schnommus/smart_cutlery_pcb/README.md

# Smart Cutlery (PCB)
ELEC3117 project, 2017S2. Jamon & Seb.
