schnommus/smart_cutlery_pcb/fab_out/rev1_pattern1/bom_digikey.xls

Refs | Value | Footprint | QTY (1 unit) | MFR | MPN | SPR | SPN | QTY (to order) | UNITS
BT1 | 3V CR1225 | BC_2011_CR1225_HOLDER:BC-2011-CR1225 | 1 | MPD (Memory Protection Devices) | BC-2011 | https://www.digikey.com.au/ | BC-2011-ND | 3 | 3
SW1 | TL3342 | Buttons_Switches_SMD:SW_SPST_TL3342 | 1 | E-Switch | TL3342F160QG/TR | https://www.digikey.com.au/ | EG2531CT-ND | 3
C8 | 100uF | Capacitors_Tantalum_SMD:CP_Tantalum_Case-B_EIA-3528-21_Reflow | 1 | AVX | F930J107MBA | https://www.digikey.com.au/ | 478-8156-1-ND | 3
C10 | 10uF | Capacitors_Tantalum_SMD:CP_Tantalum_Case-B_EIA-3528-21_Reflow | 1 | Vishay Sprague | 293D106X9016B2TE3 | https://www.digikey.com.au/ | 718-1124-1-ND | 3
C11 | 68uF | Capacitors_Tantalum_SMD:CP_Tantalum_Case-B_EIA-3528-21_Reflow | 1 | AVX | F930J686MBA | https://www.digikey.com.au/ | 478-8190-1-ND | 3
D3;D4;D5 | MBR0520 | Diodes_SMD:D_SOD-123 | 3 | Fairchild/ON | MBR0520L | https://www.digikey.com.au/ | MBR0520LCT-ND | 9
U4 | MPU-9250 | Housings_DFN_QFN:QFN-24-1EP_3x3mm_Pitch0.4mm | 1 | TDK InvenSense | MPU-9250 | https://www.digikey.com.au/ | 1428-1019-1-ND | 3
U1 | STM32L053C6Tx | Housings_QFP:LQFP-48_7x7mm_Pitch0.5mm | 1 | STMicroelectronics | STM32L053C8T6 | https://www.digikey.com.au/ | 497-14906-ND | 3
L2;L1 | 47uH | Inductors_SMD:L_0603 | 2 | Taiyo Yuden | CBMF1608T470K | https://www.digikey.com.au/ | 587-1722-1-ND | 6
U5 | ASMT-YTC2-0AA02 | LEDs:LED_RGB_PLCC-6 | 1 | Broadcom | ASMT-YTC2-0AA02 | https://www.digikey.com.au/ | 516-2513-1-ND | 3
Q2 | BSS138 | TO_SOT_Packages_SMD:SOT-23 | 1 | Fairchild/ON | BSS138L | https://www.digikey.com.au/ | BSS138LCT-ND | 3
Q1 | BSS84 | TO_SOT_Packages_SMD:SOT-23 | 1 | Diodes Inc. | BSS84-7-F | https://www.digikey.com.au/ | BSS84-FDICT-ND | 3
