schnommus/smart_cutlery_pcb/smart_cutlery_pcb.kicad_pcb

## KiCad design smart_cutlery_pcb.kicad_pcb (2017-09-09)

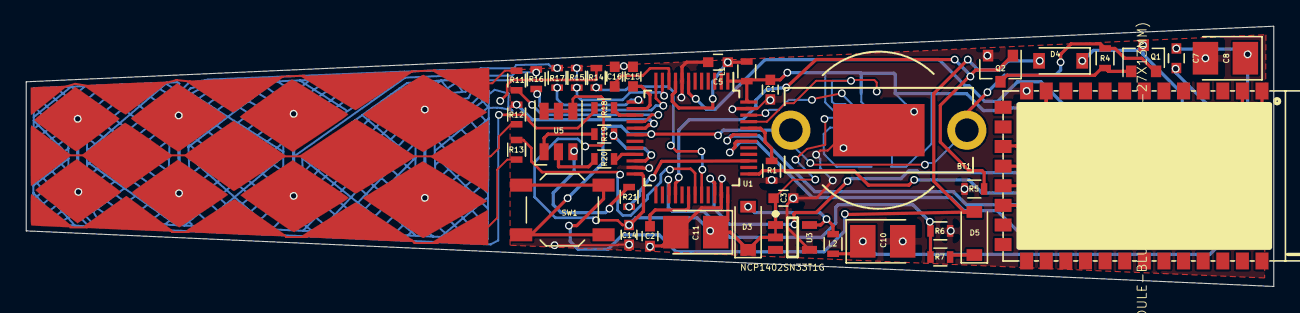
[picture p1: board smart_cutlery_pcb.kicad_pcb from above]

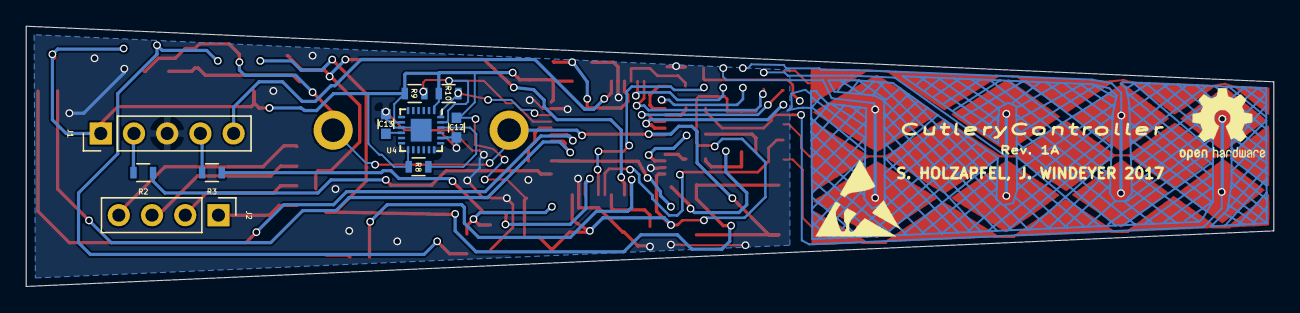
[picture p2: board smart_cutlery_pcb.kicad_pcb from below]

Board: 2 copper layers, 95.4 x 19.9 mm, 50 parts (10 on the bottom side), 44 nets.

Parts:
BT1: 3V CR1225; BC-2011-CR1225
C1, C2, C3, C5: 100n; C_0603
C7, C12, C13: 100nF; C_0603
C8: 100uF; CP_Tantalum_Case-B_EIA-3528-21_Reflow
C10: 10uF; CP_Tantalum_Case-B_EIA-3528-21_Reflow
C11: 68uF; CP_Tantalum_Case-B_EIA-3528-21_Reflow
C14, C15, C16: 47nF; C_0603
D3, D4, D5: MBR0520; D_SOD-123
J1: CONN_01X05; Pin_Header_Straight_1x05_Pitch2.54mm
J2: CONN_01X04; Pin_Header_Straight_1x04_Pitch2.54mm
L1: Ferrite; L_0603
L2: 47uH; L_0603
Q1: BSS84; SOT-23
Q2: BSS138; SOT-23
R1: 4.7k; R_0603
R2, R3: 100; R_0603
R4, R5: 100K; R_0603
R6: 4K7; R_0603
R7: 47K; R_0603
R8, R9, R10, R11, R12, R13, R14, R15, R16, R17, R18: 10K; R_0603
R19, R20, R21: 180; R_0603
SW1: TL3342; SW_SPST_TL3342
U1: STM32L053C6Tx; LQFP-48_7x7mm_Pitch0.5mm
U2: MODULE-BLUETOOTH-HC-05(34P-27X13MM); BT34P-SMD-1.5-26.9X13.0X2.2MM
U3: NCP1402SN33T1G; SOT95P275X110-5N
U4: MPU-9250; QFN-24-1EP_3x3mm_Pitch0.4mm
U5: ASMT-YTC2-0AA02; LED_RGB_PLCC-6

Connections:
+3V3: C1.1, C2.1, C3.1, C7.1, C8.1, C11.1, C12.1, D3.1, J1.1, L1.1, R8.1, R9.1, R10.1, U1.1, U1.24, U1.36, U1.48, U2.12, U3.1, U3.2, U4.1, U4.8, U4.13, U5.4, U5.5, U5.6
/ACCEL_GYRO_I2C_SCL: R9.2, U1.45, U4.23
/ACCEL_GYRO_I2C_SDA: R10.2, U1.46, U4.24
/BAT1_VSENSE: BT1.1, Q1.2, R4.2, SW1.1, U1.18
/BLUETOOTH_RX: U1.42, U2.2
/BLUETOOTH_TX: U1.43, U2.1
/LED_BLUE: R19.2, U1.22
/LED_GREEN: R20.2, U1.21
/LED_RED: R21.2, U1.39
/PWR_BUTTON: R6.1, R7.2, U1.27
/PWR_LATCH: Q2.1, R5.2, U1.28
/micro/SWD_CLK: R2.1, U1.37
/micro/SWD_IO: R3.1, U1.34
/micro/nRST: J1.5, U1.7
/touch_cap1: C16.2, U1.10
/touch_cap2: C15.2, U1.14
/touch_cap3: C14.2, U1.30
/touch_x1: R15.2, U1.11
/touch_x2: R16.2, U1.12
/touch_x3: R17.2, U1.13
/touch_x4: R18.2, U1.15
/touch_y1: R11.2, U1.16
/touch_y2: R12.2, U1.17
/touch_y3: R13.2, U1.31
/touch_y4: R14.2, U1.32
GND: BT1.2, C1.2, C2.2, C3.2, C5.2, C7.2, C8.2, C10.2, C11.2, C12.2, C13.2, C14.1, C15.1, C16.1, J1.3, Q2.2, R1.2, R5.1, R7.1, U1.8, U1.23, U1.35, U1.47, U2.13, U3.4, U4.9, U4.18, U4.20
unnamed: C5.1, L1.2, U1.9
unnamed: C10.1, D4.1, L2.1, Q1.3
unnamed: C13.1, U4.10
unnamed: D3.2, L2.2, U3.5
unnamed: D4.2, D5.2, SW1.2
unnamed: D5.1, R6.2
unnamed: J1.2, R2.2
unnamed: J1.4, R3.2
unnamed: J2.1, U2.19
unnamed: J2.2, U2.18
unnamed: J2.3, U2.17
unnamed: J2.4, U2.16
unnamed: Q1.1, Q2.3, R4.1
unnamed: R1.1, U1.44
unnamed: R8.2, U4.22
unnamed: R19.1, U5.1
unnamed: R20.1, U5.2
unnamed: R21.1, U5.3
