schnommus/smart_cutlery_pcb/boost_conv_tests.ods

L=47uH
V_in | I_in | P_in | V_out | R_out | P_out | EFF | I_out | V | Eff (47uH) | Eff (94uH)
2 | 0.102 | 0.204 | 3.3 | 800 | 0.0136125 | 0.066727941176471 | 0.004125 | 2V | 0.068671699323855 | 0.242710193492143
2 | 0.079 | 0.158 | 3.3 | 1000 | 0.01089 | 0.068924050632911 | 0.0033 | 2.5V | 0.073935971415214 | 0.189867040472222
2 | 0.059 | 0.118 | 3.3 | 1500 | 0.00726 | 0.061525423728814 | 0.0022 | 3V | 0.386949867073248 | 0.17797764924411
2 | 0.0375 | 0.075 | 3.3 | 2000 | 0.005445 | 0.0726 | 0.00165
2 | 0.0185 | 0.037 | 3.3 | 4000 | 0.0027225 | 0.073581081081081 | 0.000825
2.5 | 0.093 | 0.2325 | 3.3 | 800 | 0.0136125 | 0.058548387096774 | 0.004125
2.5 | 0.07 | 0.175 | 3.3 | 1000 | 0.01089 | 0.062228571428572 | 0.0033
2.5 | 0.045 | 0.1125 | 3.3 | 1500 | 0.00726 | 0.064533333333333 | 0.0022
2.5 | 0.033 | 0.0825 | 3.3 | 2000 | 0.005445 | 0.066 | 0.00165
2.5 | 0.0092 | 0.023 | 3.3 | 4000 | 0.0027225 | 0.118369565217391 | 0.000825
3 | 0.0114 | 0.0342 | 3.3 | 800 | 0.0136125 | 0.398026315789474 | 0.004125
3 | 0.009 | 0.027 | 3.3 | 1000 | 0.01089 | 0.403333333333333 | 0.0033
3 | 0.006 | 0.018 | 3.3 | 1500 | 0.00726 | 0.403333333333333 | 0.0022
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
