schnommus/smart_cutlery_pcb/(commit log)

2017-08-24 Added STM32L053 sub-schematic with debugging header etc
    [micro.sch, smart_cutlery_pcb.kicad_pcb, smart_cutlery_pcb.sch]
2017-08-24 Add bluetooth HC-05 module to schematic
    [bluetooth.sch, micro.sch, smart_cutlery_pcb.sch]
2017-08-26 Add bluetooth module lib
    [bluetooth.sch, micro.sch, smart_cutlery_pcb.sch]
2017-08-26 Capture boost converter, soft latching power
    [bluetooth.sch, micro.sch, power.sch, smart_cutlery_pcb.sch]
2017-08-26 Add accelerometer/gyro
    [bluetooth.sch, inertial_sensor.sch, micro.sch, power.sch, smart_cutlery_pcb.sch]
2017-08-26 Add touch interface schematic
    [bluetooth.sch, inertial_sensor.sch, micro.sch, power.sch, smart_cutlery_pcb.sch, touch_interface.sch]
2017-08-26 Make top-level connections between microcontroller and everything else
    [bluetooth.sch, inertial_sensor.sch, micro.sch, power.sch, smart_cutlery_pcb.sch, touch_interface.sch]
2017-08-26 Add optional bubble around intertial sensor pcb
    [smart_cutlery_pcb.sch]
2017-09-01 Assigned some footprints and added CR1225 holder footprint
    [bluetooth.sch, inertial_sensor.sch, micro.sch, power.sch, touch_interface.sch]
2017-09-01 Add switch footprints, add mode switch
    [micro.sch, power.sch, smart_cutlery_pcb.kicad_pcb, smart_cutlery_pcb.sch, touch_interface.sch]
2017-09-03 Update to new soft-latching power circuit
    [power.sch, smart_cutlery_pcb.kicad_pcb, smart_cutlery_pcb.sch, touch_interface.sch]
2017-09-04 Attempt layout
    [smart_cutlery_pcb.kicad_pcb]
2017-09-04 attempt 1
    [power.sch, smart_cutlery_pcb.kicad_pcb, smart_cutlery_pcb.sch, touch_interface.sch]
2017-09-05 More changes, replace
    [micro.sch, power.sch, smart_cutlery_pcb.kicad_pcb]
2017-09-05 Do some routing
    [smart_cutlery_pcb.kicad_pcb]
2017-09-06 More routing
    [smart_cutlery_pcb.kicad_pcb]
2017-09-07 finish basic routing
    [smart_cutlery_pcb.kicad_pcb]
2017-09-07 Place ref designators
    [smart_cutlery_pcb.kicad_pcb]
2017-09-09 Finish touch pattern (rev1), ground hatching, gerbers r1
    [smart_cutlery_pcb-B.Cu.gbr, smart_cutlery_pcb-B.Mask.gbr, smart_cutlery_pcb-B.SilkS.gbr, smart_cutlery_pcb-Edge.Cuts.gbr, smart_cutlery_pcb-F.Cu.gbr, smart_cutlery_pcb-F.Mask.gbr, smart_cutlery_pcb-F.SilkS.gbr, smart_cutlery_pcb.drl]
2017-09-09 Increase outline by 0.2mm on all sides to pass audit
    [smart_cutlery_pcb.kicad_pcb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]
2017-09-13 Create relevant BOM links, export digikey BOM
    [bluetooth.sch, bom_digikey.xls, inertial_sensor.sch, micro.sch, power.sch, smart_cutlery_pcb.sch, touch_interface.sch]
2017-09-28 Add boost converter test results
    [bluetooth.sch, boost_conv_tests.ods, inertial_sensor.sch, micro.sch, power.sch, smart_cutlery_pcb.sch, touch_interface.sch]
2017-09-28 Update KiCAD version, add 150uH test, add text annotating component changes
    [bluetooth.sch, boost_conv_tests.ods, inertial_sensor.sch, micro.sch, power.sch, smart_cutlery_pcb.sch, touch_interface.sch]
2017-09-30 More inductor tests
    [boost_conv_tests.ods]
2017-10-06 add efficiency readings for latest inductor
    [boost_conv_tests.ods]
